FranciscoCou077/Sistema-de-Validacion-de-Plausibilidad-del-APPS-Accelerator-Pedal-Position-Sensor-/(commit log)

2026-07-17 Update .gitignore to include additional patterns
    Added various file patterns and directories to .gitignore for Arduino IDE, OS, editors, and backup files.
2026-07-17 feat: agregar simulacion Wokwi del circuito APPS
2026-07-17 docs: agregar reporte tecnico en LaTeX con evidencia fotografica y capturas de Monitor Serie
2026-07-17 feat: implementar sistema de plausibilidad APPS con arquitectura de 3 capas
    Adquisicion por timer de hardware a 1kHz, calibracion independiente
    por canal y logica de seguridad con debounce de 100ms segun regla
    T.4.2 de Formula SAE.
2026-07-17 feat: agregar dashboard web de telemetria APPS con Web Serial API
    Visualizacion en tiempo real de ambos canales, banda de plausibilidad
    con umbral de 10%, indicador de debounce y grafica historica, conectado
    directo al ESP32 por USB sin backend.
